bigjosh/Voyant-power-DAC-array/img/cut-trace.png

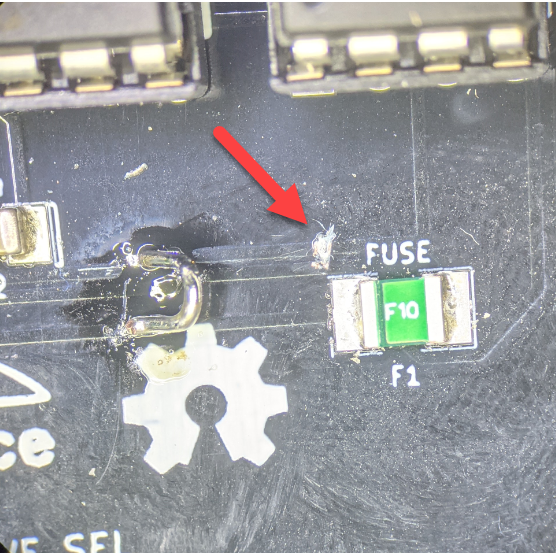
img/cut-trace.png
