bigjosh/Voyant-power-DAC-array/img/feedback-front.png

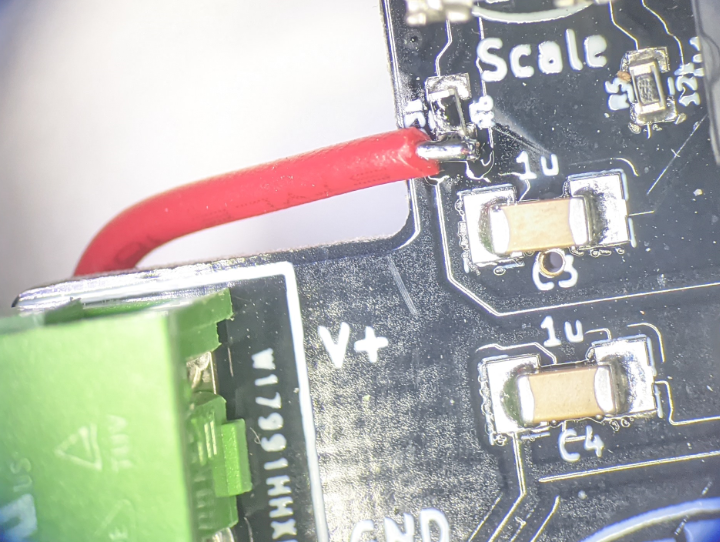
img/feedback-front.png
