bigjosh/Voyant-power-DAC-array/dac_shield.pdf

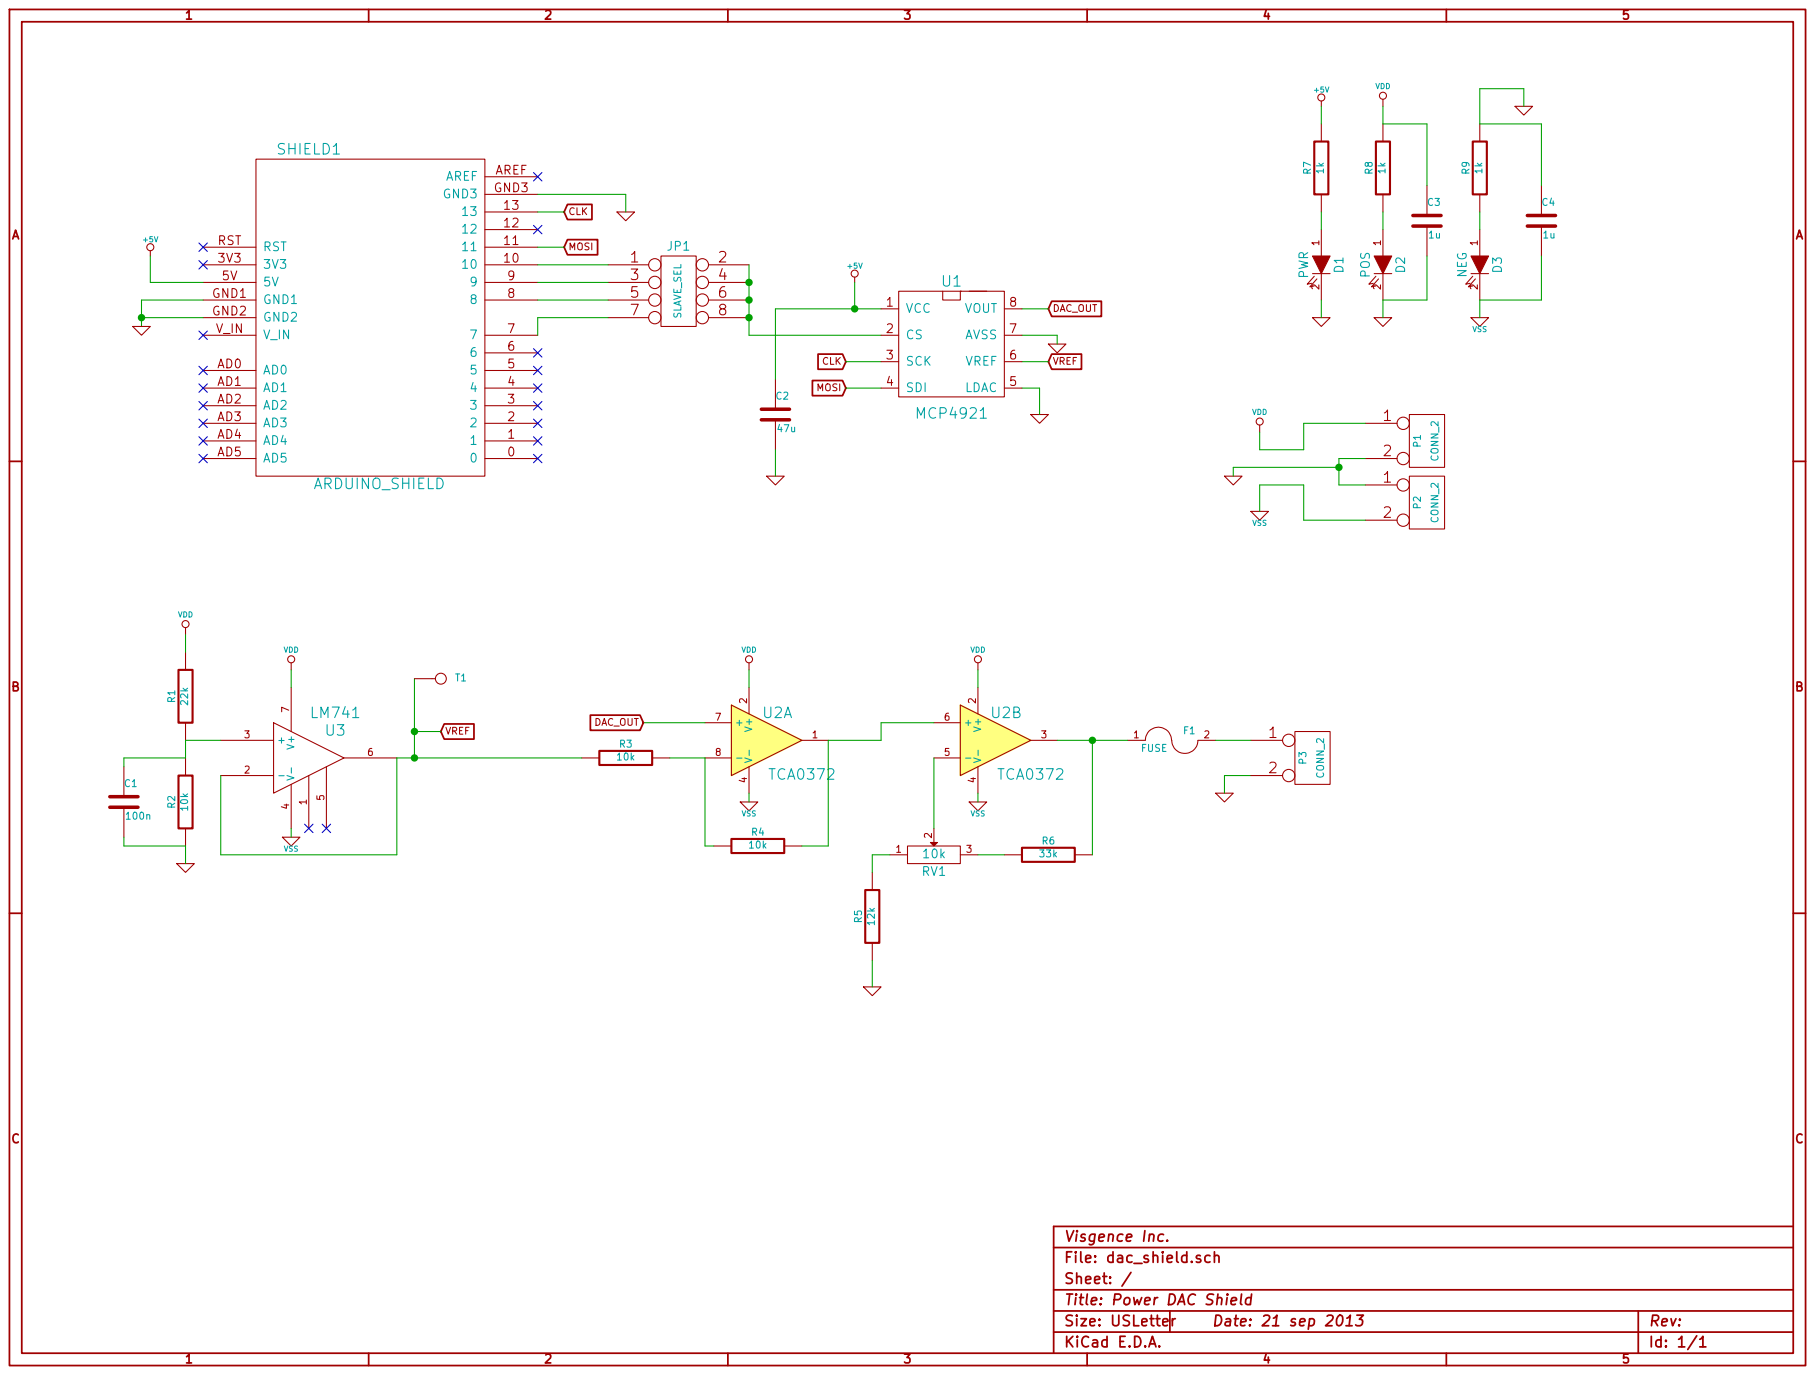
[picture p7: page 1]

9 3 | 4
8 5 | 6

Visgence Inc.
File: dac_shield.sch
Sheet: /
Title: Power DAC Shield
KiCad E.D.A.
