bigjosh/Voyant-power-DAC-array/(commit log)

2021-07-21 Firmware complete, just needs calibration
2021-07-21 Final calibration.
