bigjosh/Voyant-power-DAC-array/img/power-jumpers.jpg

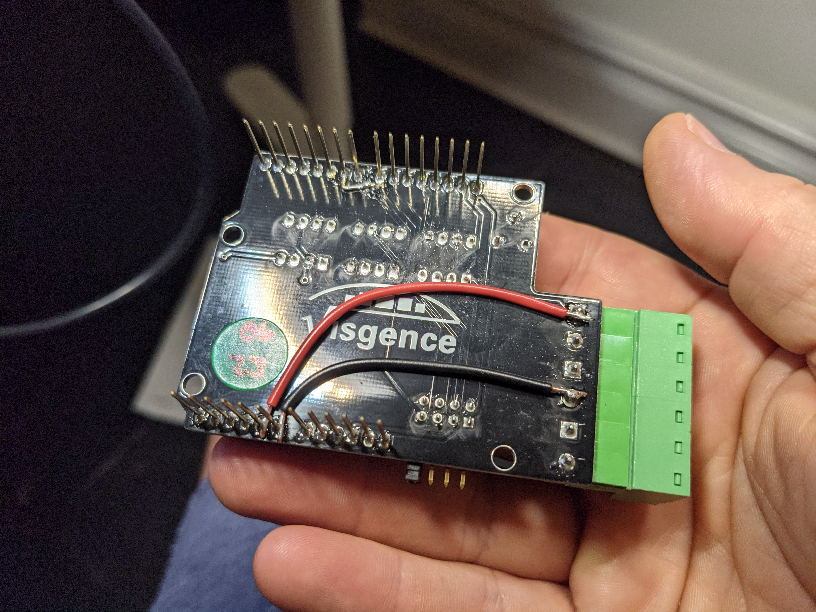
img/power-jumpers.jpg
